mtrunzo12/TreasureBox-build/PARTS.csv

board | Reference | Qty | Value | DNP | Exclude from BOM | Exclude from Board | Footprint
treasure_box_main | C1,C2 | 2 | 22pF |  |  |  | Capacitor_THT:C_Disc_D3.0mm_W1.6mm_P2.50mm
treasure_box_main | C3,C4,C5,C6,C9,C10 | 6 | 100nF |  |  |  | Capacitor_THT:C_Disc_D3.0mm_W1.6mm_P2.50mm
treasure_box_main | C7 | 1 | 470uF |  |  |  | Capacitor_THT:CP_Radial_D8.0mm_P3.50mm
treasure_box_main | C8 | 1 | 100uF |  |  |  | Capacitor_THT:CP_Radial_D6.3mm_P2.50mm
treasure_box_main | D1,D2 | 2 | 1N4007 |  |  |  | Diode_THT:D_DO-41_SOD81_P10.16mm_Horizontal
treasure_box_main | D3 | 1 | 1N5819 |  |  |  | Diode_THT:D_DO-41_SOD81_P10.16mm_Horizontal
treasure_box_main | J1 | 1 | SPKR |  |  |  | TerminalBlock:TerminalBlock_MaiXu_MX126-5.0-02P_1x02_P5.00mm
treasure_box_main | J2 | 1 | PIEZO |  |  |  | TerminalBlock:TerminalBlock_MaiXu_MX126-5.0-02P_1x02_P5.00mm
treasure_box_main | J3 | 1 | REED |  |  |  | TerminalBlock:TerminalBlock_MaiXu_MX126-5.0-02P_1x02_P5.00mm
treasure_box_main | J4 | 1 | TILT |  |  |  | TerminalBlock:TerminalBlock_MaiXu_MX126-5.0-02P_1x02_P5.00mm
treasure_box_main | J5 | 1 | SERVO |  |  |  | TerminalBlock:TerminalBlock_MaiXu_MX126-5.0-03P_1x03_P5.00mm
treasure_box_main | J6 | 1 | BATT |  |  |  | TerminalBlock:TerminalBlock_MaiXu_MX126-5.0-02P_1x02_P5.00mm
treasure_box_main | J7 | 1 | PWR_SW |  |  |  | TerminalBlock:TerminalBlock_MaiXu_MX126-5.0-02P_1x02_P5.00mm
treasure_box_main | J8 | 1 | USB_C_Receptacle_USB2.0_14P |  |  |  | Connector_USB:USB_C_Receptacle_HRO_TYPE-C-31-M-12
treasure_box_main | J9 | 1 | PANEL |  |  |  | Connector_IDC:IDC-Header_2x08_P2.54mm_Vertical
treasure_box_main | Q1 | 1 | S8050 |  |  |  | Package_TO_SOT_THT:TO-92_Inline
treasure_box_main | R1,R6 | 2 | 10k |  |  |  | Resistor_THT:R_Axial_DIN0207_L6.3mm_D2.5mm_P10.16mm_Horizontal
treasure_box_main | R2 | 1 | 1k |  |  |  | Resistor_THT:R_Axial_DIN0207_L6.3mm_D2.5mm_P10.16mm_Horizontal
treasure_box_main | R3,R4 | 2 | 22R |  |  |  | Resistor_THT:R_Axial_DIN0207_L6.3mm_D2.5mm_P10.16mm_Horizontal
treasure_box_main | R5 | 1 | 1M |  |  |  | Resistor_THT:R_Axial_DIN0207_L6.3mm_D2.5mm_P10.16mm_Horizontal
treasure_box_main | R7,R8 | 2 | 5.1k |  |  |  | Resistor_THT:R_Axial_DIN0207_L6.3mm_D2.5mm_P10.16mm_Horizontal
treasure_box_main | U1 | 1 | ATmega328P-PU |  |  |  | Package_DIP:DIP-28_W7.62mm_Socket
treasure_box_main | U3 | 1 | CH340C |  |  |  | Package_SO:SOIC-16_3.9x9.9mm_P1.27mm
treasure_box_main | Y1 | 1 | 16MHz |  |  |  | Crystal:Crystal_HC49-4H_Vertical
treasure_box_frontpanel | C101 | 1 | 100nF |  |  |  | Capacitor_THT:C_Disc_D5.0mm_W2.5mm_P5.00mm
treasure_box_frontpanel | D101 | 1 | LED_BLUE |  |  |  | TerminalBlock:TerminalBlock_MaiXu_MX126-5.0-02P_1x02_P5.00mm
treasure_box_frontpanel | D102 | 1 | LED_GREEN |  |  |  | TerminalBlock:TerminalBlock_MaiXu_MX126-5.0-02P_1x02_P5.00mm
treasure_box_frontpanel | D103 | 1 | LED_RED |  |  |  | TerminalBlock:TerminalBlock_MaiXu_MX126-5.0-02P_1x02_P5.00mm
treasure_box_frontpanel | J101 | 1 | PANEL_IN |  |  |  | Connector_IDC:IDC-Header_2x08_P2.54mm_Vertical
treasure_box_frontpanel | J102 | 1 | KEYPAD |  |  |  | Connector_JST:JST_XH_B8B-XH-A_1x08_P2.50mm_Vertical
treasure_box_frontpanel | J103 | 1 | ARM_SW |  |  |  | TerminalBlock:TerminalBlock_MaiXu_MX126-5.0-02P_1x02_P5.00mm
treasure_box_frontpanel | R101,R102 | 2 | 150R |  |  |  | Resistor_THT:R_Axial_DIN0207_L6.3mm_D2.5mm_P10.16mm_Horizontal
treasure_box_frontpanel | R103 | 1 | 220R |  |  |  | Resistor_THT:R_Axial_DIN0207_L6.3mm_D2.5mm_P10.16mm_Horizontal
