mtrunzo12/TreasureBox-build/treasure_box_frontpanel/treasure_box_frontpanel.csv

Reference | Qty | Value | DNP | Exclude from BOM | Exclude from Board | Footprint
C101 | 1 | 100nF |  |  |  | Capacitor_THT:C_Disc_D5.0mm_W2.5mm_P5.00mm
D101 | 1 | LED_BLUE |  |  |  | TerminalBlock:TerminalBlock_MaiXu_MX126-5.0-02P_1x02_P5.00mm
D102 | 1 | LED_GREEN |  |  |  | TerminalBlock:TerminalBlock_MaiXu_MX126-5.0-02P_1x02_P5.00mm
D103 | 1 | LED_RED |  |  |  | TerminalBlock:TerminalBlock_MaiXu_MX126-5.0-02P_1x02_P5.00mm
J101 | 1 | PANEL_IN |  |  |  | Connector_IDC:IDC-Header_2x08_P2.54mm_Vertical
J102 | 1 | KEYPAD |  |  |  | Connector_JST:JST_XH_B8B-XH-A_1x08_P2.50mm_Vertical
J103 | 1 | ARM_SW |  |  |  | TerminalBlock:TerminalBlock_MaiXu_MX126-5.0-02P_1x02_P5.00mm
R101,R102 | 2 | 150R |  |  |  | Resistor_THT:R_Axial_DIN0207_L6.3mm_D2.5mm_P10.16mm_Horizontal
R103 | 1 | 220R |  |  |  | Resistor_THT:R_Axial_DIN0207_L6.3mm_D2.5mm_P10.16mm_Horizontal
