mtrunzo12/TreasureBox-build/treasure_box_frontpanel/treasure_box_frontpanel.kicad_pcb

## KiCad design treasure_box_frontpanel/treasure_box_frontpanel.kicad_pcb (2026-10-24)

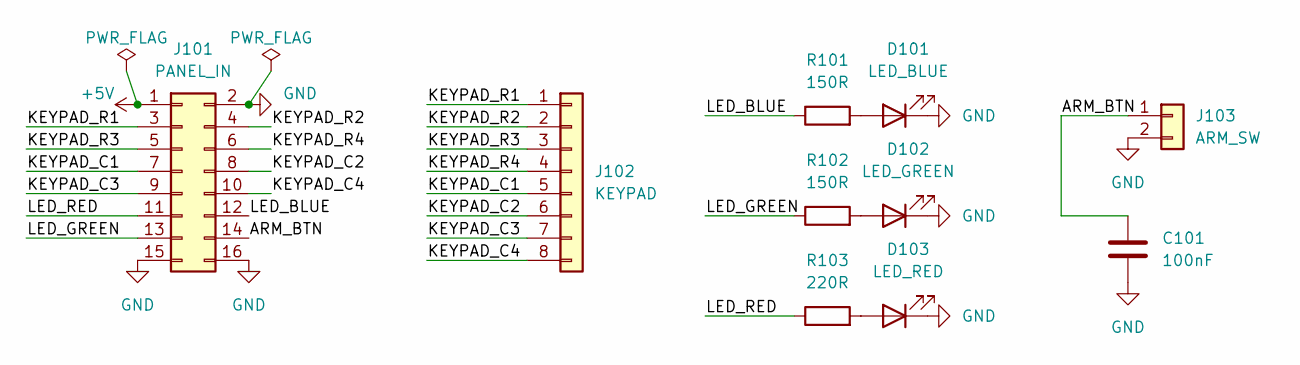
[picture p1: schematic treasure_box_frontpanel.kicad_sch, Treasure Box - Front Panel]

Parts:
C101: 100nF; C_Disc_D5.0mm_W2.5mm_P5.00mm
D101: LED_BLUE; TerminalBlock_MaiXu_MX126-5.0-02P_1x02_P5.00mm
D102: LED_GREEN; TerminalBlock_MaiXu_MX126-5.0-02P_1x02_P5.00mm
D103: LED_RED; TerminalBlock_MaiXu_MX126-5.0-02P_1x02_P5.00mm
J101: PANEL_IN; IDC-Header_2x08_P2.54mm_Vertical
J102: KEYPAD; JST_XH_B8B-XH-A_1x08_P2.50mm_Vertical
J103: ARM_SW; TerminalBlock_MaiXu_MX126-5.0-02P_1x02_P5.00mm
R101, R102: 150R; R_Axial_DIN0207_L6.3mm_D2.5mm_P10.16mm_Horizontal
R103: 220R; R_Axial_DIN0207_L6.3mm_D2.5mm_P10.16mm_Horizontal

Connections:
+5V: J101.1
/ARM_BTN: C101.1, J101.14, J103.1
/KEYPAD_C1: J101.7, J102.5
/KEYPAD_C2: J101.8, J102.6
/KEYPAD_C3: J101.9, J102.7
/KEYPAD_C4: J101.10, J102.8
/KEYPAD_R1: J101.3, J102.1
/KEYPAD_R2: J101.4, J102.2
/KEYPAD_R3: J101.5, J102.3
/KEYPAD_R4: J101.6, J102.4
/LED_BLUE: J101.12, R101.1
/LED_GREEN: J101.13, R102.1
/LED_RED: J101.11, R103.1
GND: C101.2, D101.1 (K), D102.1 (K), D103.1 (K), J101.2, J101.15, J101.16, J103.2
unnamed: D101.2 (A), R101.2
unnamed: D102.2 (A), R102.2
unnamed: D103.2 (A), R103.2

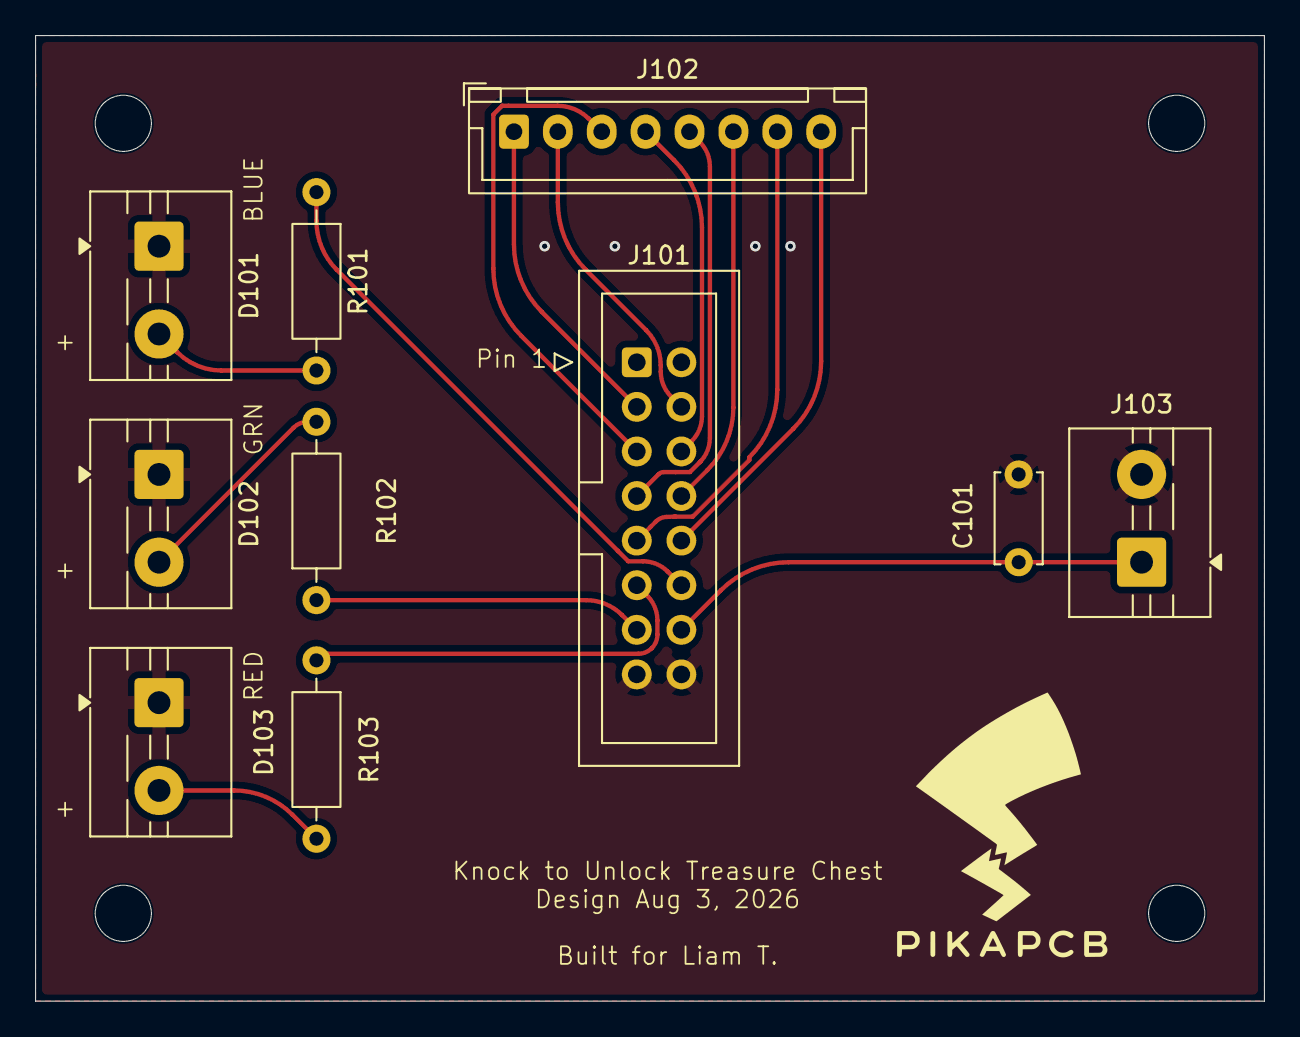
[picture p2: board treasure_box_frontpanel.kicad_pcb from above]

Board: 2 copper layers, 70.0 x 55.0 mm, 15 parts (0 on the bottom side), 16 nets.

Other parts of the board:
Mount: MountingHole_3.2mm_M3
Mount#2, Mount#3, Mount#4: MountingHole_3.2mm_M3
P: LOGO; PikaPCBsmall
