mtrunzo12/TreasureBox-build/treasure_box_main/treasure_box_main.kicad_pcb

## KiCad design treasure_box_main/treasure_box_main.kicad_pcb (2026-10-24)

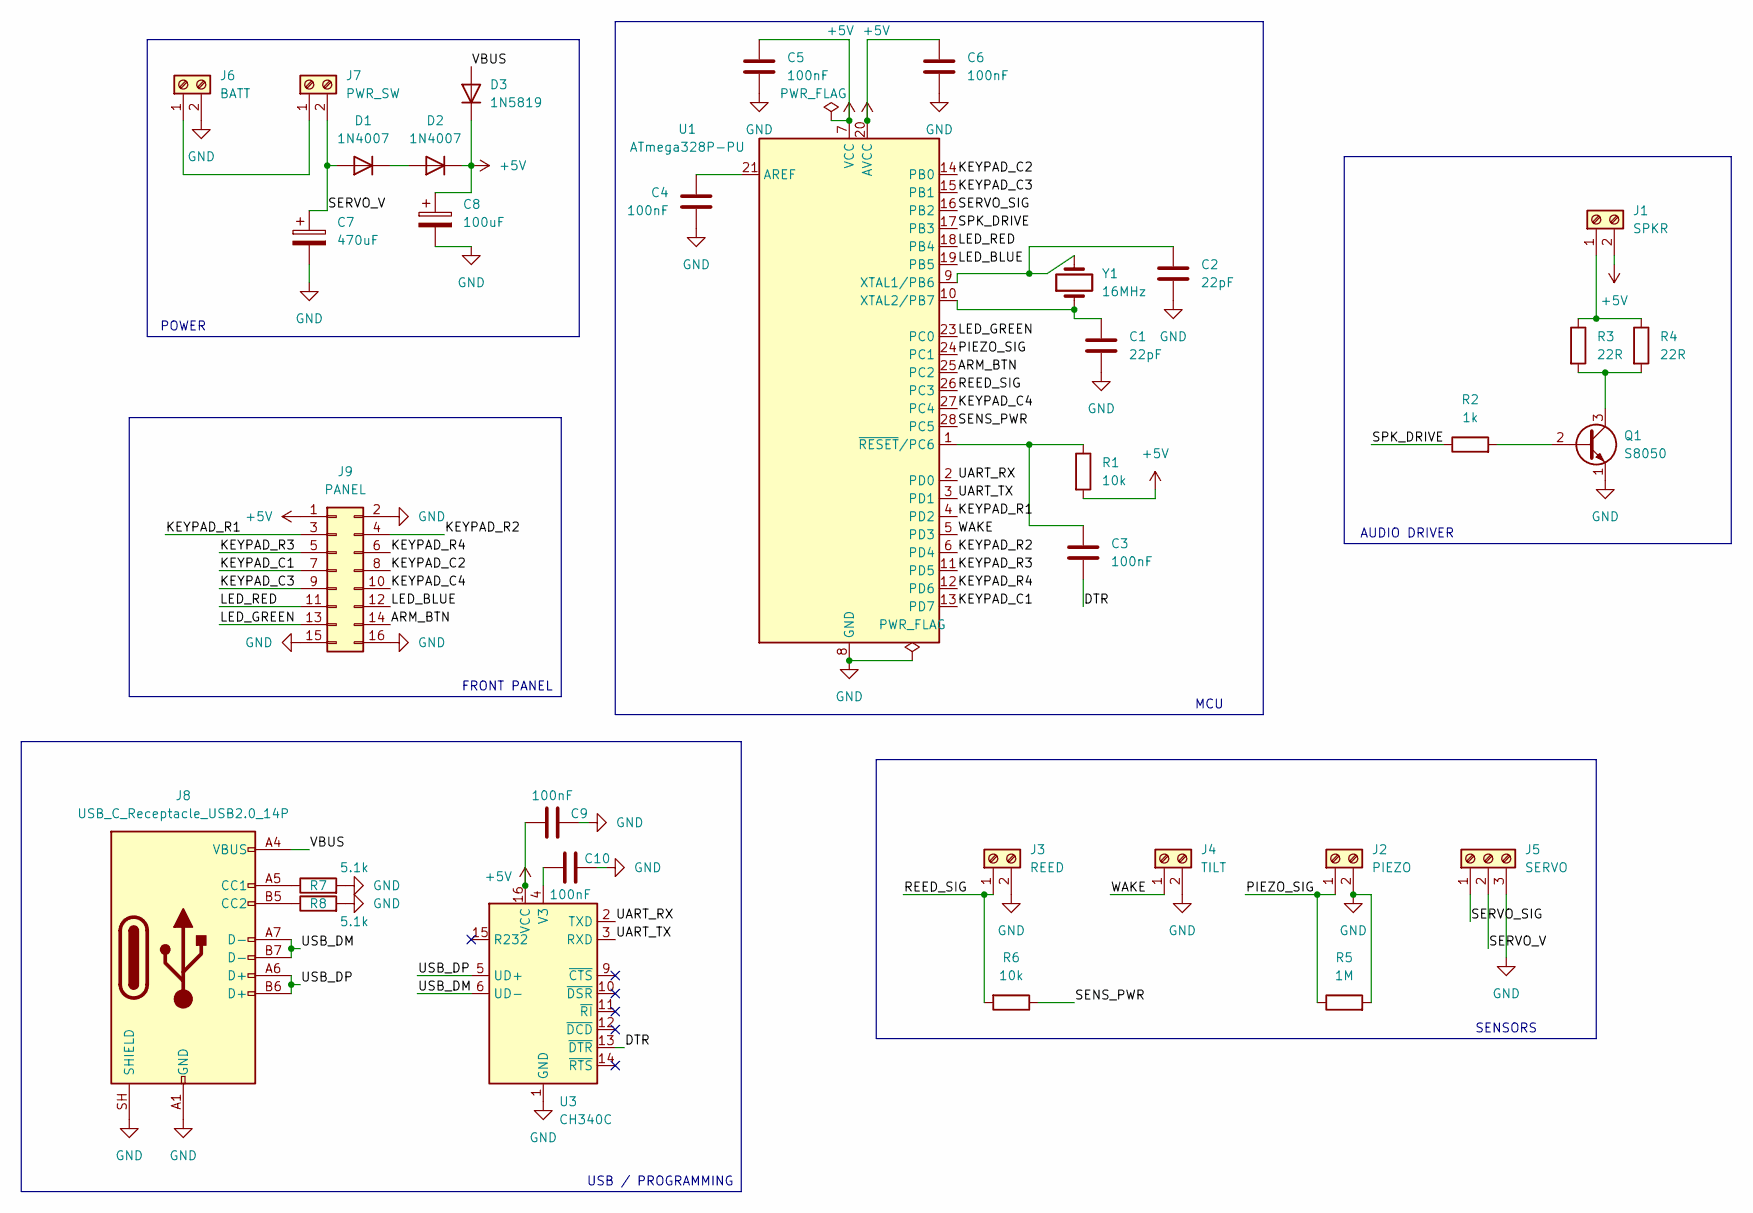
[picture p3: schematic treasure_box_main.kicad_sch, Treasure Box - Main Control Board]

Parts:
C1, C2: 22pF; C_Disc_D3.0mm_W1.6mm_P2.50mm
C3, C4, C5, C6, C9, C10: 100nF; C_Disc_D3.0mm_W1.6mm_P2.50mm
C7: 470uF; CP_Radial_D8.0mm_P3.50mm
C8: 100uF; CP_Radial_D6.3mm_P2.50mm
D1, D2: 1N4007; D_DO-41_SOD81_P10.16mm_Horizontal
D3: 1N5819; D_DO-41_SOD81_P10.16mm_Horizontal
J1: SPKR; TerminalBlock_MaiXu_MX126-5.0-02P_1x02_P5.00mm
J2: PIEZO; TerminalBlock_MaiXu_MX126-5.0-02P_1x02_P5.00mm
J3: REED; TerminalBlock_MaiXu_MX126-5.0-02P_1x02_P5.00mm
J4: TILT; TerminalBlock_MaiXu_MX126-5.0-02P_1x02_P5.00mm
J5: SERVO; TerminalBlock_MaiXu_MX126-5.0-03P_1x03_P5.00mm
J6: BATT; TerminalBlock_MaiXu_MX126-5.0-02P_1x02_P5.00mm
J7: PWR_SW; TerminalBlock_MaiXu_MX126-5.0-02P_1x02_P5.00mm
J8: USB_C_Receptacle_USB2.0_14P; USB_C_Receptacle_HRO_TYPE-C-31-M-12
J9: PANEL; IDC-Header_2x08_P2.54mm_Vertical
Q1: S8050; TO-92_Inline
R1, R6: 10k; R_Axial_DIN0207_L6.3mm_D2.5mm_P10.16mm_Horizontal
R2: 1k; R_Axial_DIN0207_L6.3mm_D2.5mm_P10.16mm_Horizontal
R3, R4: 22R; R_Axial_DIN0207_L6.3mm_D2.5mm_P10.16mm_Horizontal
R5: 1M; R_Axial_DIN0207_L6.3mm_D2.5mm_P10.16mm_Horizontal
R7, R8: 5.1k; R_Axial_DIN0207_L6.3mm_D2.5mm_P10.16mm_Horizontal
U1: ATmega328P-PU; DIP-28_W7.62mm_Socket
U3: CH340C; SOIC-16_3.9x9.9mm_P1.27mm
Y1: 16MHz; Crystal_HC49-4H_Vertical

Connections:
+5V: C5.1, C6.1, C8.1, C9.1, D2.1 (K), D3.1 (K), J1.2, J9.1, R1.2, U1.7 (VCC), U1.20 (AVCC), U3.16 (VCC)
/ARM_BTN: J9.14, U1.25 (PC2)
/DTR: C3.2, U3.13 (~DTR)
/KEYPAD_C1: J9.7, U1.13 (PD7)
/KEYPAD_C2: J9.8, U1.14 (PB0)
/KEYPAD_C3: J9.9, U1.15 (PB1)
/KEYPAD_C4: J9.10, U1.27 (PC4)
/KEYPAD_R1: J9.3, U1.4 (PD2)
/KEYPAD_R2: J9.4, U1.6 (PD4)
/KEYPAD_R3: J9.5, U1.11 (PD5)
/KEYPAD_R4: J9.6, U1.12 (PD6)
/LED_BLUE: J9.12, U1.19 (PB5)
/LED_GREEN: J9.13, U1.23 (PC0)
/LED_RED: J9.11, U1.18 (PB4)
/PIEZO_SIG: J2.1, R5.1, U1.24 (PC1)
/REED_SIG: J3.1, R6.2, U1.26 (PC3)
/SENS_PWR: R6.1, U1.28 (PC5)
/SERVO_SIG: J5.1, U1.16 (PB2)
/SERVO_V: C7.1, D1.2 (A), J5.2, J7.2
/SPK_DRIVE: R2.1, U1.17 (PB3)
/UART_RX: U1.2 (PD0), U3.2 (TXD)
/UART_TX: U1.3 (PD1), U3.3 (RXD)
/USB_DM: J8.A7 (D-), J8.B7 (D-), U3.6 (UD-)
/USB_DP: J8.A6 (D+), J8.B6 (D+), U3.5 (UD+)
/VBUS: D3.2 (A), J8.A4 (VBUS), J8.A9 (VBUS), J8.B4 (VBUS), J8.B9 (VBUS)
/WAKE: J4.1, U1.5 (PD3)
GND: C1.2, C2.2, C4.2, C5.2, C6.2, C7.2, C8.2, C9.2, C10.2, J2.2, J3.2, J4.2, J5.3, J6.2, J8.A1 (GND), J8.A12 (GND), J8.B1 (GND), J8.B12 (GND), J8.SH (SHIELD), J9.2, J9.15, J9.16, Q1.1 (E), R5.2, R7.2, R8.2, U1.8 (GND), U1.22 (GND), U3.1 (GND)
unnamed: D1.1 (K), D2.2 (A)
unnamed: J1.1, R3.1, R4.1
unnamed: J6.1, J7.1
unnamed: J8.A5 (CC1), R7.1
unnamed: J8.B5 (CC2), R8.1
unnamed: Q1.2 (B), R2.2
unnamed: Q1.3 (C), R3.2, R4.2
unnamed: C4.1, U1.21 (AREF)
unnamed: C2.1, U1.9 (XTAL1/PB6), Y1.2
unnamed: C1.1, U1.10 (XTAL2/PB7), Y1.1
unnamed: C3.1, R1.1, U1.1 (~RESET/PC6)
unnamed: C10.1, U3.4 (V3)

Notes on the sheet:
FRONT PANEL
SENSORS
AUDIO DRIVER
POWER
USB / PROGRAMMING
MCU

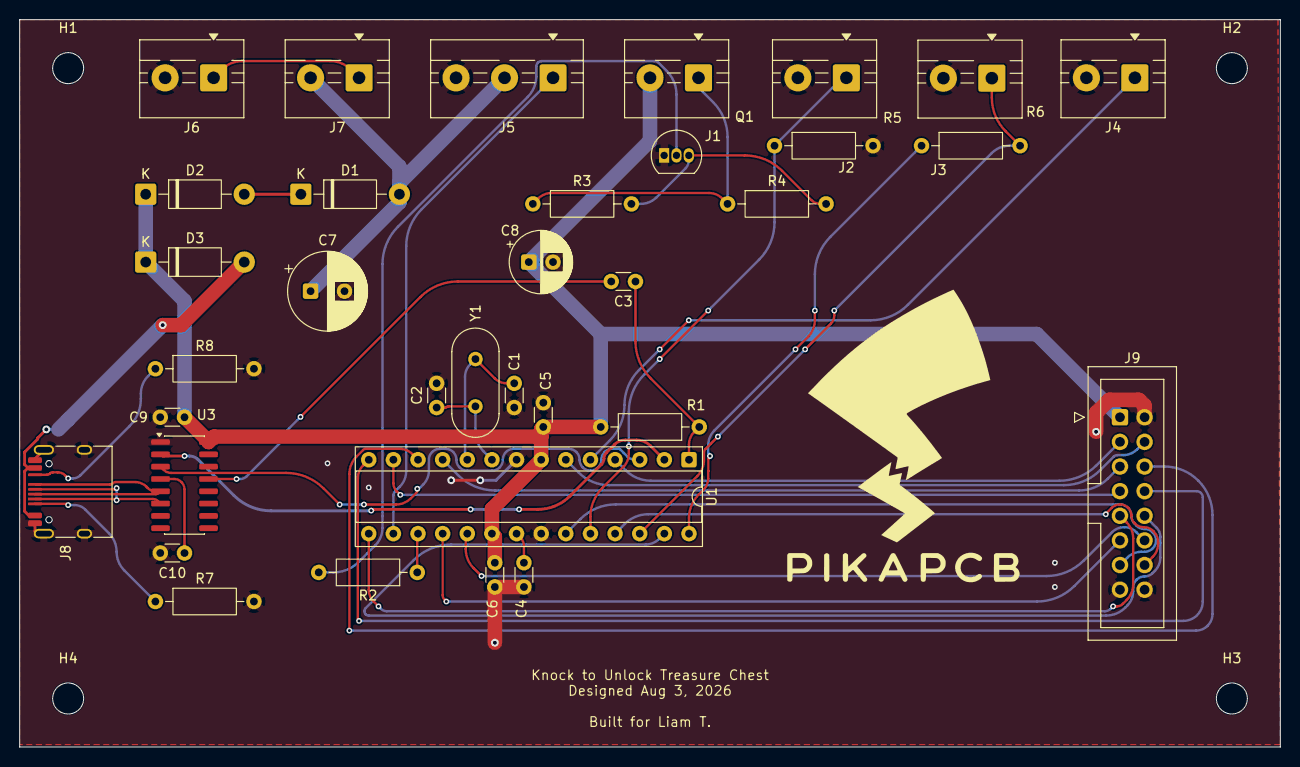
[picture p4: board treasure_box_main.kicad_pcb from above]

Board: 2 copper layers, 130.0 x 75.0 mm, 38 parts (0 on the bottom side), 39 nets.

Other parts of the board:
H1, H2, H3, H4: MountingHole_3.2mm_M3
