mtrunzo12/TreasureBox-build/firmware/treasure_box/music_themes.h

#pragma once
#include <Arduino.h>
#include <avr/pgmspace.h>

// Original monophonic scores for the transistor-driven speaker on D11.
// 0: Dungeon (Zelda-style, retains v8.3 score); 1: Trainer (Pokemon-style);
// 2: Arcade (Mario-style). No samples or recordings are required.
const byte THEME_COUNT=3;
const byte CUE_ARM=0, CUE_ERROR=1, CUE_SAVED=2, CUE_DIGIT=3;

const uint16_t THEME_BOOT_NOTES[THEME_COUNT][3] PROGMEM={
  {523,659,784},
  {784,988,1175},
  {659,1047,1568}
};

const uint16_t THEME_BOOT_LENGTHS[THEME_COUNT][3] PROGMEM={
  {70,70,130},
  {65,95,150},
  {45,65,120}
};

const uint16_t THEME_KEY_NOTES[THEME_COUNT][10] PROGMEM={
  {523,587,659,784,880,1047,1175,1319,1568,1760},
  {392,440,494,587,659,784,880,988,1175,1319},
  {659,784,1047,880,1319,1175,1568,1397,1760,2093}
};

const uint16_t THEME_UI_NOTES[THEME_COUNT][4] PROGMEM={
  {659,233,1568,1047},
  {988,196,1760,1175},
  {1319,175,2093,1568}
};

const uint16_t THEME_HEARTBEAT_NOTES[THEME_COUNT][2] PROGMEM={
  {110,147},
  {131,196},
  {165,247}
};

const uint16_t THEME_HEARTBEAT_SHAPE[THEME_COUNT][3] PROGMEM={
  {14,22,40},
  {18,28,45},
  {10,20,32}
};

const uint16_t THEME_BUILD_NOTES[THEME_COUNT][24] PROGMEM={
  {330,392,494,659,370,440,554,740,392,494,587,784,440,554,659,880,494,587,740,988,554,659,784,1109},
  {392,587,494,659,784,659,587,740,440,659,554,740,880,740,659,831,494,740,587,880,988,1175,988,1319},
  {523,784,659,1047,0,784,880,659,587,880,740,1175,0,880,988,740,659,988,784,1319,0,1175,1568,1319}
};

const uint16_t THEME_BUILD_LENGTHS[THEME_COUNT][24] PROGMEM={
  {145,142,139,136,133,130,127,124,121,118,115,112,109,106,103,100,97,94,91,88,85,82,79,76},
  {140,90,90,170,90,90,120,120,120,80,80,150,80,80,100,100,100,70,70,120,65,65,65,160},
  {80,80,150,80,75,100,70,120,75,75,135,75,65,90,65,110,65,65,120,65,55,65,65,150}
};

const uint16_t THEME_BUILD_TAIL[THEME_COUNT][2] PROGMEM={
  {988,1480},
  {1175,1568},
  {1568,1047}
};

const uint16_t THEME_BUILD_TAIL_TIMING[THEME_COUNT][2] PROGMEM={
  {90,290},
  {110,230},
  {60,320}
};

const uint16_t THEME_REVEAL_NOTES[THEME_COUNT][10] PROGMEM={
  {784,587,784,988,1175,1568,1480,1319,1175,1568},
  {587,784,988,880,1175,988,1319,1175,1568,1568},
  {1047,0,784,1319,1175,1568,0,1319,2093,1568}
};

const uint16_t THEME_REVEAL_LENGTHS[THEME_COUNT][10] PROGMEM={
  {130,90,130,180,180,360,110,110,180,720},
  {100,100,180,90,180,100,200,110,130,600},
  {100,70,80,150,80,160,70,80,120,380}
};

const uint16_t THEME_DISARM_NOTES[THEME_COUNT][4] PROGMEM={
  {659,784,988,1319},
  {784,1175,988,1568},
  {1047,784,1319,2093}
};

const uint16_t THEME_DISARM_LENGTHS[THEME_COUNT][4] PROGMEM={
  {55,55,65,140},
  {60,70,50,130},
  {40,60,40,150}
};

const uint16_t THEME_FAILURE_NOTES[THEME_COUNT][5] PROGMEM={
  {392,370,330,294,247},
  {587,494,440,370,294},
  {659,622,494,523,262}
};

const uint16_t THEME_FAILURE_LENGTHS[THEME_COUNT][5] PROGMEM={
  {160,170,170,170,620},
  {120,110,180,130,460},
  {80,80,140,90,480}
};

const uint16_t THEME_ALARM_NOTES[THEME_COUNT][24] PROGMEM={
  {330,494,622,659,622,494,349,523,659,698,659,523,392,554,740,784,740,554,370,523,698,740,698,523},
  {294,440,349,587,554,440,330,494,392,659,622,494,349,523,415,698,659,523,370,554,440,740,698,554},
  {392,554,523,370,494,466,415,587,554,392,523,494,440,622,587,415,554,523,466,659,622,440,587,554}
};

const uint16_t THEME_ALARM_LENGTHS[THEME_COUNT][24] PROGMEM={
  {140,70,70,100,70,70,140,70,70,100,70,70,140,70,70,100,70,70,140,70,70,100,70,140},
  {120,60,60,120,60,90,100,60,60,100,60,90,90,50,50,90,50,80,90,50,50,90,50,140},
  {70,70,110,50,50,110,65,65,100,45,45,100,60,60,90,45,45,90,60,60,85,40,40,150}
};
